hw-myry/itm-hiwi/06.report/week2/week2.pdf

## Bericht

Jiaqi Wang

June 28, 2026

## 1 Hardware-Verbindungsdiagramm

Mit der Software Fritzing wurde ein Schaltplan für die Hardwareverbindungen erstellt. Dadurch sind die elektrischen Verbindungen übersichtlich und klar erkennbar. Außerdem dient der Schaltplan als Grundlage für die spätere Verdrahtung und das anschließende Löten der Schaltung.

Das erstellte Hardware-Verbindungsdiagramm ist in Abbildung 1 dargestellt.


Figure 1: Hardware-Verbindungsdiagramm des Versuchsaufbaus

## 2 TCP-Kommunikation und Closed-Loop-Steuerung

In der verbesserten Version wurde die TCP-Kommunikation mit der Closed-Loop-Steuerung kombiniert. Dadurch kann der Schrittmotor über WLAN ferngesteuert werden. Die vom PC gesendeten Winkelbefehle werden vom ESP32-S3 empfangen und anschließend an die Motorsteuerung weitergegeben.

Da nicht an jedem Einsatzort ein 2,4 GHz-WLAN verfügbar ist, wurde zusätzlich ein AP-Modus implementiert. Der ESP32-S3 kann somit entweder mit einem vorhandenen WLAN verbunden werden oder selbst einen WLAN-Hotspot bereitstellen. Der Wechsel zwischen beiden Modi erfolgt durch eine einfache #define-Anweisung.

Das folgende Programmfragment zeigt die grundlegende Umschaltung zwischen WLANund AP-Modus:

#define NETMODE 1

WiFiServer server(8080);

void setupNetwork() {
#if NETMODE == 0

WiFi.mode(WIFI_STA);
WiFi.begin(WIFI_SSID, WIFI_PASS);

#elif NETMODE == 1

WiFi.mode(WIFI_AP);
WiFi.softAP(AP_SSID, AP_PASS); #endif

server.begin();
}

## 3 PID-Regelung zur Verbesserung der Genauigkeit

Zur weiteren Verbesserung der Positioniergenauigkeit wurde die Closed-Loop-Steuerung um eine PID-Regelung erweitert. Dabei wird der Sollwinkel mit dem vom Drehgeber gemessenen Istwinkel verglichen. Aus der Differenz entsteht der Regelungsfehler, der vom PID-Regler verarbeitet wird. Das Ergebnis wird anschließend zur Anpassung der Schrittfrequenz des Motors verwendet.

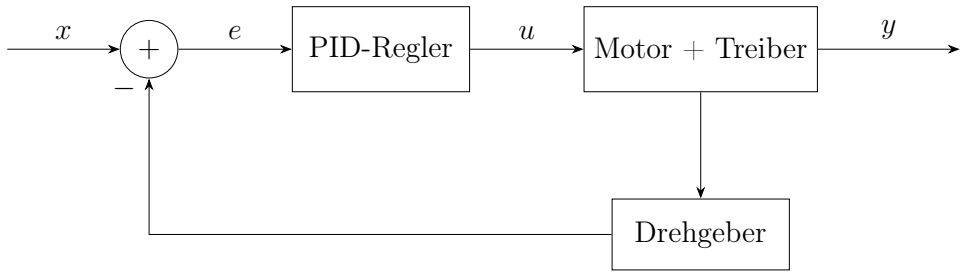
[picture p9: figure]
PID-Regler; Motor + Treiber; Drehgeber

Figure 2: Blockdiagramm der Closed-Loop-Steuerung mit PID-Regler

In Abbildung 2 beschreibt x den Sollwinkel und y den gemessenen Istwinkel des Motors. Der Fehler e ergibt sich aus der Differenz zwischen Soll- und Istwert. Der PID-Regler berechnet daraus das Steuersignal u, mit dem die Schrittfrequenz des Schrittmotors angepasst wird.

Der PID-Regler besteht aus drei Anteilen. Der P-Anteil reagiert direkt auf den aktuellen Fehler. Der I-Anteil berücksichtigt die aufsummierte Abweichung über die Zeit und kann bleibende Fehler reduzieren. Der D-Anteil reagiert auf die Änderungsgeschwindigkeit des Fehlers und kann Überschwingen verringern.

Das folgende Programmfragment zeigt den zentralen Teil der PID-Berechnung:

float error = targetAngle - currentAngle;

integral += error * dt;
float derivative = (error - lastError) / dt;

float pidOutput = pidKp * error
+ pidKi * integral
+ pidKd * derivative;

bool dir = error > 0.0f;
float usedSpeedHz = fabs(pidOutput);

if (usedSpeedHz < localMinSpeedHz) { usedSpeedHz = localMinSpeedHz;
}

if (usedSpeedHz > maxSpeedHz) { usedSpeedHz = maxSpeedHz;
}

In diesem Programm wird der PID-Ausgang nicht direkt als Winkel verwendet, sondern zur Bestimmung der Schrittfrequenz. Die Drehrichtung wird durch das Vorzeichen des Fehlers bestimmt. Dadurch dreht der Motor in Richtung des Zielwinkels, während die Geschwindigkeit abhängig von der Größe des Fehlers angepasst wird.

Die verwendeten Standardparameter sind:

Table 1: Einfluss der einstellbaren Regelungsparameter

Parameter | Wert | Bei Erhöhung | Bei Verringerung
Kp | 5.0 | Der | Motor | reagiert
schneller auf Positionsfehler. Bei zu hohem
Wert kann es jedoch zu
Überschwingen kommen.
Die | Reaktion | wird
langsamer. Die Zielposition wird weniger schnell
erreicht.
Ki | 0.015 | Bleibende Abweichungen
| | werden | stärker | aus-
geglichen. Ein zu hoher
Wert kann jedoch zu
Instabilität führen.

Das System läuft ruhiger,
aber | ein | dauerhafter
Restfehler kann bestehen
bleiben.
Kd | 0.0 | Schnelle Fehleränderun-
| | gen | werden | stärker
gedämpft. Dadurch kann
Überschwingen reduziert
werden.
Die | Dämpfung | wird
geringer. Der Motor kann
stärker nachschwingen.
Speed | 500 step/s | Die Schrittfrequenz wird
höher. Der Motor bewegt
sich schneller, kann bei zu hoher Geschwindigkeit jedoch Schritte verlieren.
Die | Bewegung | wird
langsamer, | dafür läuft
der Motor meist stabiler.
Encoder CPR | 40 | Eine höhere Impulszahl
pro Umdrehung führt zu
einer feineren Winkelauflösung, wenn der Encoder dies unterstützt.
Eine | niedrigere | Im-
pulszahl verringert die
Winkelauflösung und
kann die Positionsbestimmung ungenauer machen.
Tolerance | 4.5° | Die | Zielposition | wird
früher als erreicht akzeptiert. Dadurch stoppt der
Motor schneller, aber mit
geringerer Genauigkeit.

Die Positionsgenauigkeit
steigt, jedoch kann der
Motor länger nachregeln
oder unruhiger werden.

Zusätzlich können die Parameter Encoder CPR und Tolerance eingestellt werden. Encoder CPR beschreibt die Anzahl der Encoder-Impulse pro vollständiger Umdrehung. Aus diesem Wert berechnet der ESP32-S3 die Winkelauflösung des Drehgebers:

W inkelproImpuls =

360◦
EncoderCP R

Bei einem Wert von 40 entspricht ein Encoder-Impuls somit:

360◦
40

= 9◦

Dieser Parameter muss zum verwendeten Drehgeber passen. Wenn der Wert falsch eingestellt ist, berechnet der Mikrocontroller eine falsche Winkelposition.

Der Parameter Tolerance gibt die zulässige Abweichung zwischen Sollwinkel und Istwinkel an. In der aktuellen Einstellung beträgt die Toleranz 4.5

◦
. Das bedeutet, dass die Bewegung als abgeschlossen gilt, sobald der Fehler kleiner oder gleich 4.5

◦
ist.

Eine größere Toleranz führt dazu, dass der Motor schneller stoppt, jedoch mit geringerer Genauigkeit. Eine kleinere Toleranz erhöht die Positionsgenauigkeit, kann aber dazu führen, dass der Motor länger nachregelt oder unruhiger läuft.

## 4 Automatische Nullpunktsuche mit Flash-Speicherung

Zusätzlich wurde eine Funktion zur automatischen Rückkehr zum Nullpunkt nach dem Einschalten implementiert. Bei Schrittmotoren wird hierfür häufig ein Hall-Sensor oder eine Lichtschranke verwendet. Dabei dreht sich der Motor nach dem Einschalten so lange, bis der Sensor ausgelöst wird. Diese Position wird dann als mechanischer Nullpunkt definiert.

Da im aktuellen Aufbau kein entsprechender Sensor zur Verfügung steht, wurde eine alternative softwarebasierte Methode umgesetzt. Der ESP32-S3 besitzt unterschiedliche Speicherbereiche. Der RAM ist schnell, verliert seine Daten jedoch nach dem Ausschalten. Der Flash-Speicher ist dagegen nichtflüchtig, sodass gespeicherte Werte auch nach einem Neustart erhalten bleiben.

In diesem Programm wird die aktuelle relative Motorposition als Winkelwert im Flash gespeichert. Dabei wird die Drehrichtung berücksichtigt. Eine Drehung in positiver Richtung wird als positiver Wert gespeichert, eine Drehung in negativer Richtung als negativer Wert.

Beispiel:

30◦ + 40◦ = 70◦

Wenn der Motor also zuerst um 30◦ und danach um 40◦
in positiver Richtung gedreht wird, wird im Flash der Wert +70◦ gespeichert. Beim nächsten Einschalten liest der ESP32-S3 diesen Wert aus und führt automatisch eine Gegenbewegung von −70◦ aus. Dadurch wird der Motor wieder näherungsweise zum ursprünglichen Nullpunkt zurückgeführt.

Das folgende Programmfragment zeigt das Grundprinzip dieser Funktion:

#define ENABLE_AUTO_HOME_FLASH 1

Preferences prefs;
float savedHomeOffsetAngle = 0.0f;

void updateSavedHomeOffsetByActualDelta(float actualDelta) { savedHomeOffsetAngle =
normalizeHomeOffsetAngle(savedHomeOffsetAngle + actualDelta);

saveHomeOffsetToFlash();
}

float getAutoHomeMoveAngle() {
float pos = normalizeHomeOffsetAngle(savedHomeOffsetAngle);

if (fabs(pos) <= POSITION_ZERO_EPS) {
return 0.0f;
}

return -pos;
}

Der Vorteil dieser Methode besteht darin, dass keine zusätzlichen externen Sensoren benötigt werden. Dadurch bleibt der Hardwareaufbau einfacher. Allerdings ist die Zuverlässigkeit geringer als bei einer echten Referenzfahrt mit Sensor. Wenn der Motor Schritte verliert, die Welle im ausgeschalteten Zustand manuell verdreht wird oder die gespeicherte Position nicht exakt der realen Position entspricht, kann der berechnete Nullpunkt fehlerhaft sein.

Aus diesem Grund stellt diese Lösung nur eine softwarebasierte Annäherung an die Nullpunktsuche dar. Für eine präzisere und robustere Lösung wäre später der Einsatz eines Hall-Sensors oder einer Lichtschranke sinnvoll.

## 5 Verbesserung der Benutzeroberfläche

Neben der Erweiterung des ESP32-S3-Programms wurde auch die Qt-basierte Benutzeroberfläche verbessert. In der neuen Version können mehrere Regelungs- und Systemparameter direkt über den PC eingestellt werden. Dadurch ist es möglich, die Motorsteuerung drahtlos zu testen und die Parameter ohne erneutes Flashen des ESP32-S3 anzupassen. Die verbesserte Benutzeroberfläche ist in Abbildung 3 dargestellt. Über diese Oberfläche können die Regelungsparameter eingestellt, gespeichert und die Motorbewegung gesteuert werden.

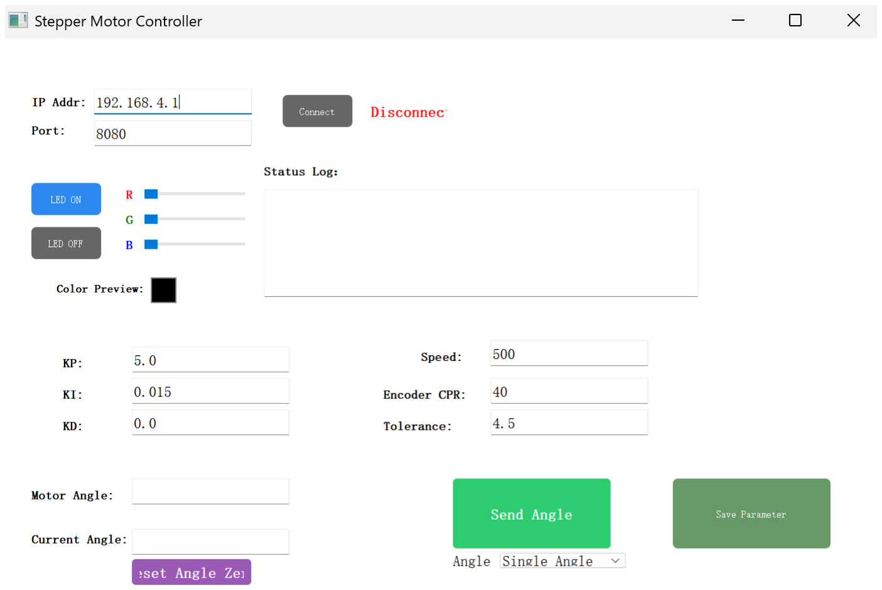
[picture p10: figure]

Figure 3: Verbesserte Qt-Benutzeroberfläche zur Motorsteuerung

Insgesamt wurden sechs einstellbare Parameter in die Benutzeroberfläche integriert:

Table 2: Einstellbare Parameter in der Benutzeroberfläche
Parameter | Funktion
Kp | Proportionalanteil des PID-Reglers
Ki | Integralanteil des PID-Reglers
Kd | Differentialanteil des PID-Reglers
Speed | Schrittfrequenz des Motors
Encoder CPR Anzahl der Encoder-Impulse pro Umdrehung
Tolerance | Zulässige Abweichung zwischen Soll- und Istwinkel

Nach dem Ändern der Parameter können diese über die Schaltfläche Save Parameter an den ESP32-S3 gesendet werden. Anschließend werden die Werte im Flash-Speicher gespeichert. Dadurch bleiben die Einstellungen auch nach einem Neustart erhalten.
Das folgende Programmfragment zeigt die Übertragung der Parameter an den ESP32-S3:

sendCommand(QString("PID:%1,%2,%3").arg(kp).arg(ki).arg(kd)); sendCommand(QString("SPEED:%1").arg(speed)); sendCommand(QString("ENCODER:%1").arg(cpr)); sendCommand(QString("TOL:%1").arg(tol));

sendCommand("CFG_SAVE");

Zusätzlich wurde eine Reset-Funktion ergänzt. Über die Schaltfläche Reset Angle Zero kann die aktuell gespeicherte Winkelposition zurückgesetzt werden. Dabei wird der Befehl ZERO an den ESP32-S3 gesendet. Dadurch wird die aktuelle Position als neuer Nullpunkt verwendet und der gespeicherte Positionswert im Flash zurückgesetzt.

sendCommand("ZERO");

Außerdem wurde die Motorsteuerung um verschiedene Betriebsarten erweitert. Im Modus Single Angle wird ein einzelner Winkelbefehl an den ESP32-S3 gesendet. Nach Abschluss der Bewegung wartet die Benutzeroberfläche auf die Rückmeldung MOTOR_DONE, bevor ein neuer Winkel gesendet werden kann.

Im Modus Back-and-Forth wird der eingegebene Winkel abwechselnd in positiver und negativer Richtung gesendet. Dadurch kann der Motor automatisch eine wiederholte Hin- und Herbewegung ausführen. Diese Funktion ist besonders hilfreich, um das Regelverhalten, die Positioniergenauigkeit und die Stabilität des Systems über mehrere Bewegungszyklen zu testen.

Das folgende Programmfragment zeigt das Grundprinzip der Umschaltung zwischen Einzelbewegung und Hin- und Herbewegung:

if (currentAngleSendMode() == MODE_BACK_AND_FORTH) {

gAngleSequenceRunning = true; gBackAndForthBaseAngle = angleValue; gBackAndForthSentCount = 1;
} else {
gAngleSequenceRunning = false;
}

QString cmd = QString("ANGLE:%1").arg(formatAngleForCommand(firstAngle)); sendCommand(cmd);

Die verbesserte Benutzeroberfläche erleichtert damit die Inbetriebnahme und Optimierung des Systems. Besonders die Fernparametrierung, das Speichern der Parameter im Flash, die Nullpunkt-Rücksetzung sowie die automatische Hin- und Herbewegung sind hilfreich, um das Verhalten des Motors unter verschiedenen Einstellungen zu untersuchen.
