hw-myry/itm-hiwi/06.report/week3/labor.jpg

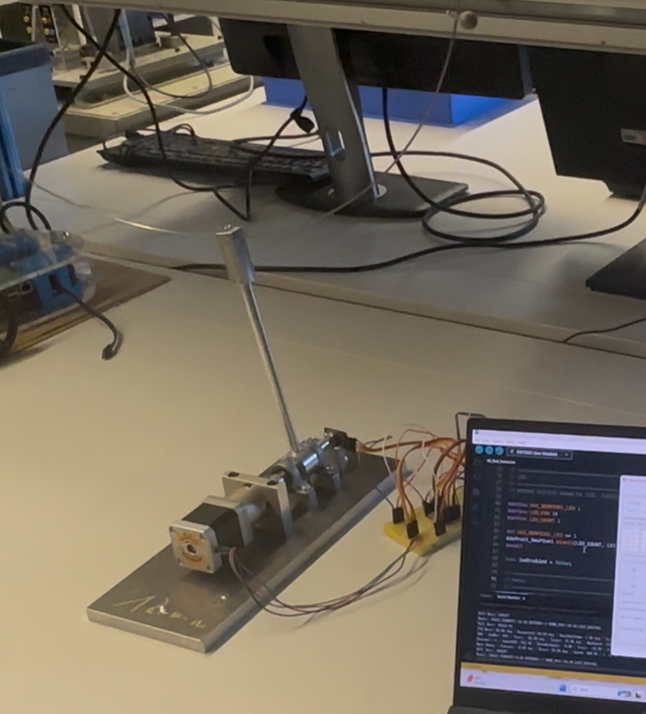
06.report/week3/labor.jpg
