hw-myry/itm-hiwi/02.3d/target_point/arm/meshes/Traumfaenger_EXPORT_arm.obj

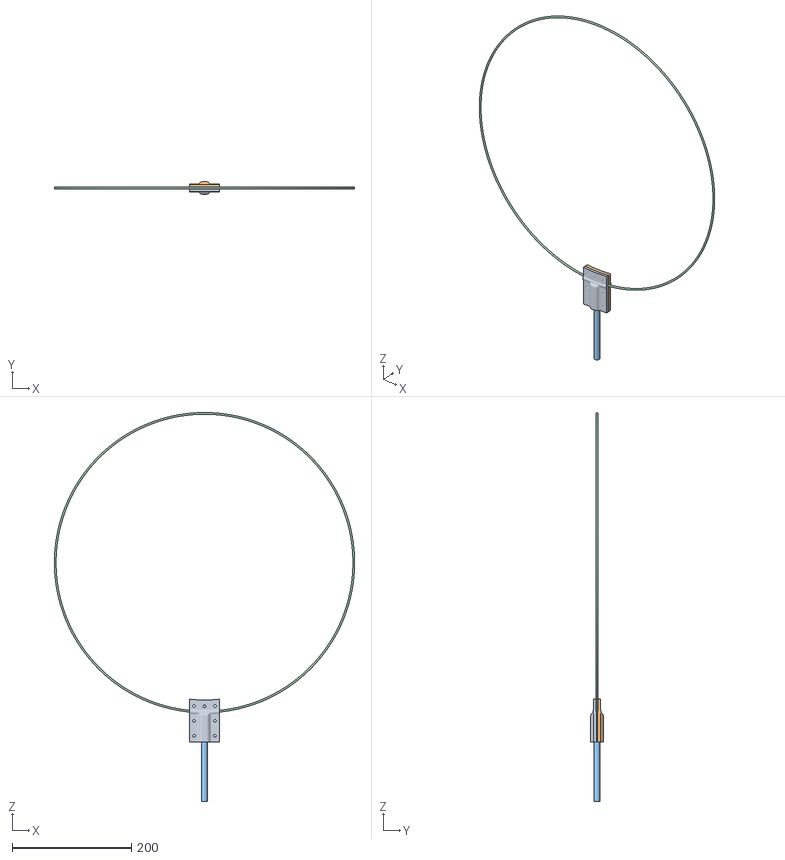
[picture p14: CAD file, 2026-07-29]
02.3d/target_point/arm/meshes/Traumfaenger_EXPORT_arm.obj
503.0 x 21.0 x 651.5
Klemme (1)
Klemme
Stab
