hw-myry/itm-hiwi/02.3d/target_point/motor/meshes/Traumfaenger_EXPORT_motor.obj

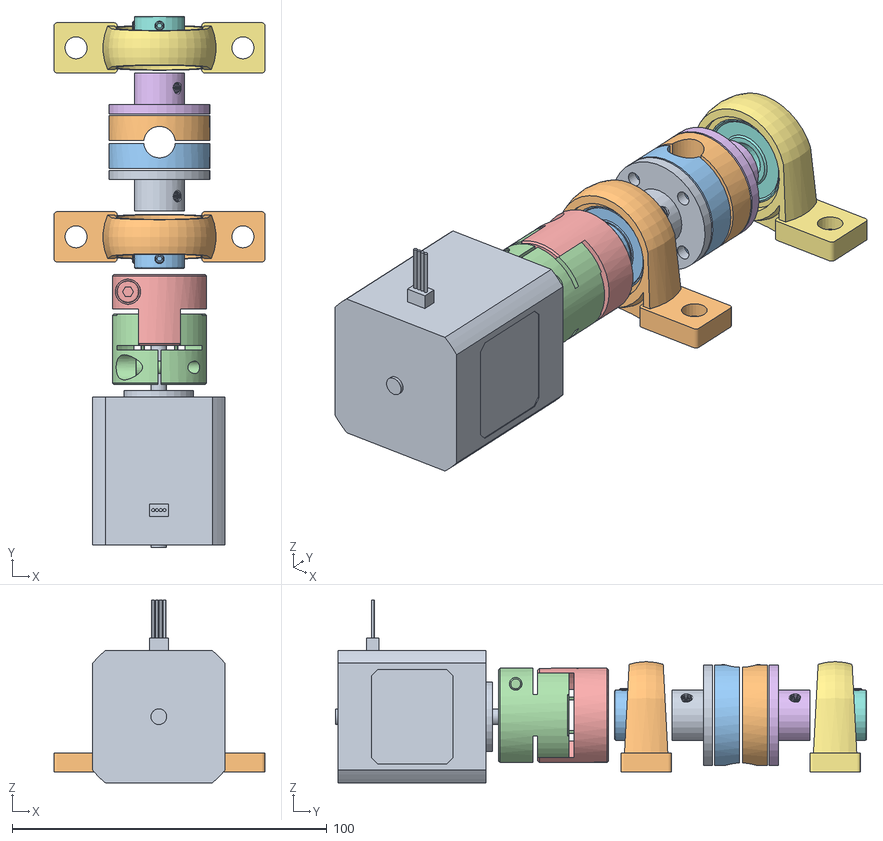
[picture p15: CAD file, 2026-07-29]
02.3d/target_point/motor/meshes/Traumfaenger_EXPORT_motor.obj
67.0 x 168.7 x 58.0
Flansch10mm
Flansch10mm (1)
KlemmeFlansch (1)
KlemmeFlansch
