hw-myry/itm-hiwi/(list of files, cad)

Other CAD files:
3d/target_point/base/meshes/Traumfaenger_EXPORT_base.obj
02.3d/target_point/TargetPoint_v1.1.f3z
