hw-myry/itm-hiwi/02.3d/target_point/test.png

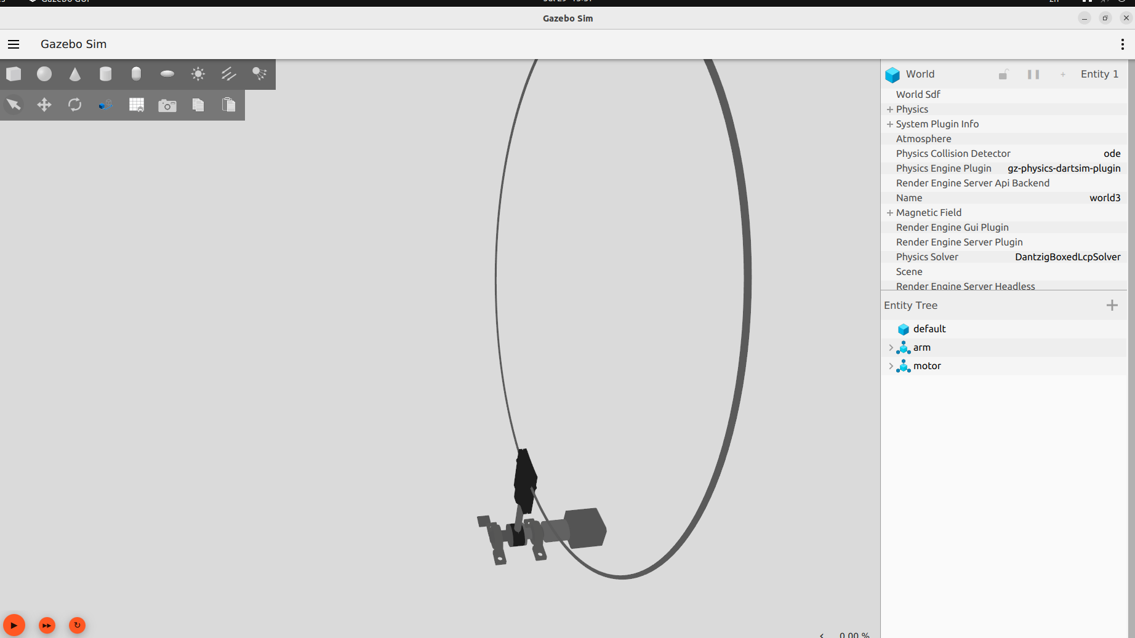
02.3d/target_point/test.png
