hw-myry/itm-hiwi/04.host_pc/test/images/wifi.png

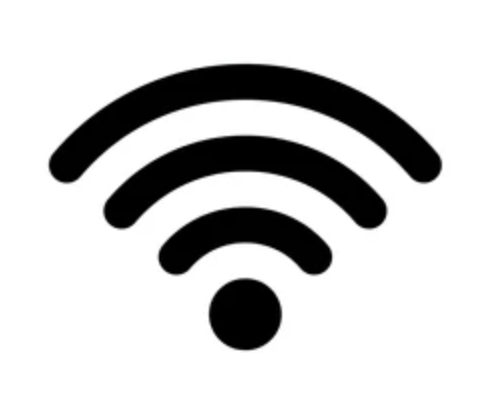
04.host_pc/test/images/wifi.png
