hw-myry/itm-hiwi/04.host_pc/test/motor-symbol.jpg

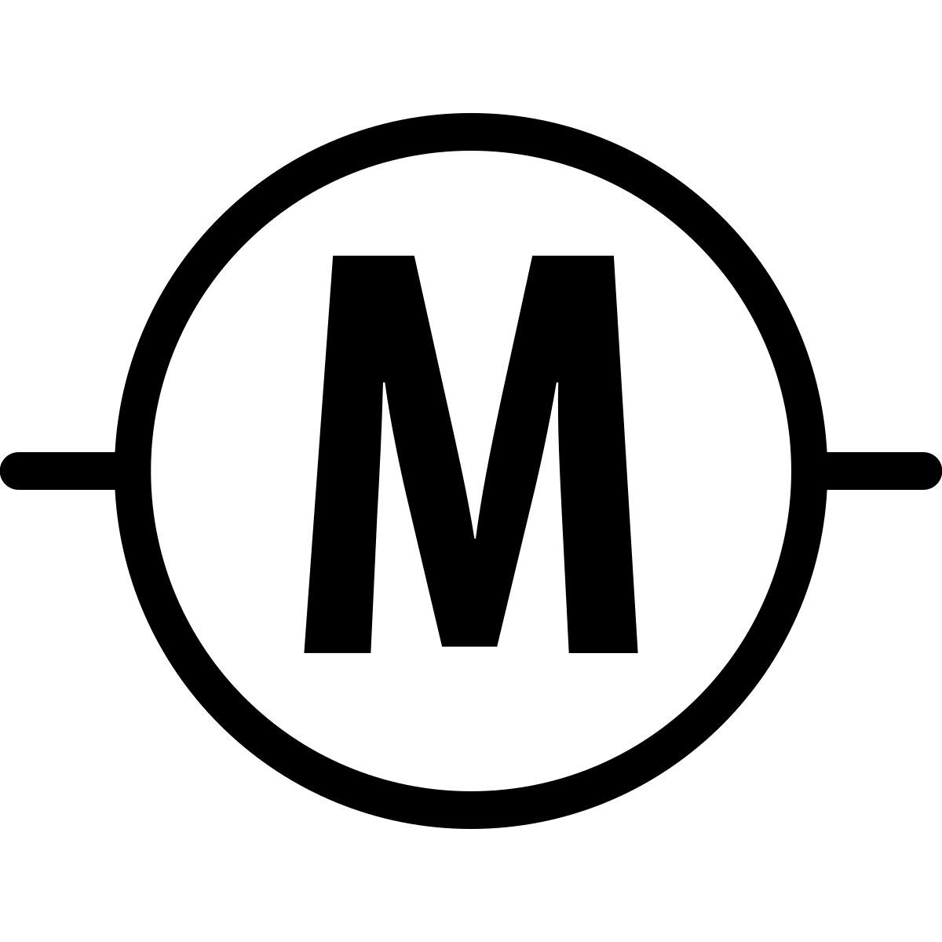
04.host_pc/test/motor-symbol.jpg
