hw-myry/itm-hiwi/(list of files, drawings)

Other design files:
03.circuit/schematic.fzz
