hw-myry/itm-hiwi/(commit log)

2026-06-10 add motor test file
2026-06-25 add pid control
    [schematic.fzz]
2026-06-26 5 backlash
2026-06-26 add reset function on host pc
    [08_find_home.ino, mainwindow.cpp]
2026-07-07 test encoder
    [schematic.fzz]
2026-07-07 add compare current vs set angle
2026-07-08 add save flash and delete CPR, Tolerance function
    [01_motor_test.ino, 08_find_home.ino, mainwindow.cpp]
2026-07-09 add restart ESP32 function
2026-07-16 sim torque with matlab
2026-07-29 add 3d file
    [TargetPoint.f3z, TargetPoint_v1.1.f3z, Traumfaenger_EXPORT_arm.obj]
2026-07-29 arm, success import gazebo
    [Traumfaenger_EXPORT_arm.obj, model.sdf, world.sdf]
2026-07-29 import base
    [Traumfaenger_EXPORT_base.obj, expanded_world.sdf, model.sdf, world.sdf]
2026-07-29 add motor file
    [Traumfaenger_EXPORT_motor.obj, model.sdf]
2026-07-29 success import arm and motor into gazebo
    [Traumfaenger_EXPORT_motor.obj, expanded_world.sdf, model.sdf, world.sdf, world1.sdf, world2.sdf, world3.sdf]
2026-07-29 rename files
    [TargetPoint_v1.1.f3z, Traumfaenger_EXPORT_arm.obj, Traumfaenger_EXPORT_motor.obj, model.sdf, schematic.fzz, world1.sdf, world2.sdf, world3.sdf]
